SchmoJan/autonom-fahrendes-auto/IMG_20191203_085014.jpg

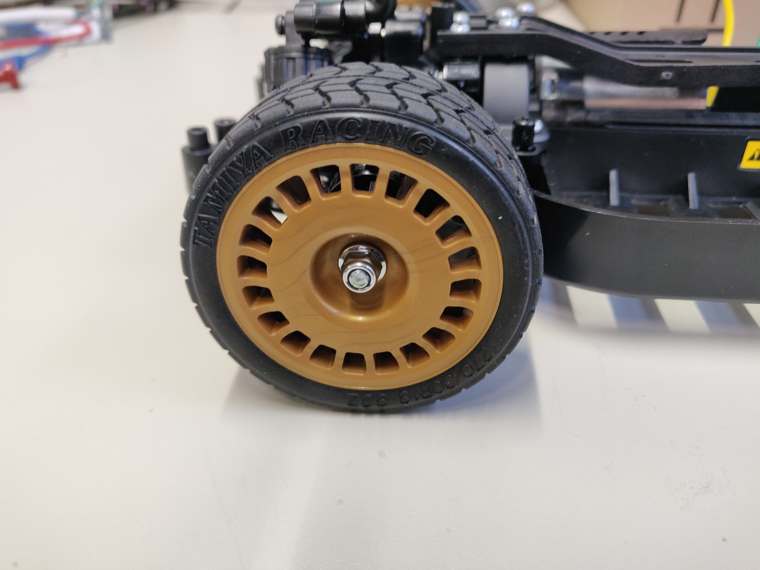
IMG_20191203_085014.jpg
