SchmoJan/autonom-fahrendes-auto/README.md

# autonom-fahrendes-auto

# Diplomarbeit der HTL WIEN 10
