SchmoJan/autonom-fahrendes-auto/IMG-20200114-WA0015.jpg

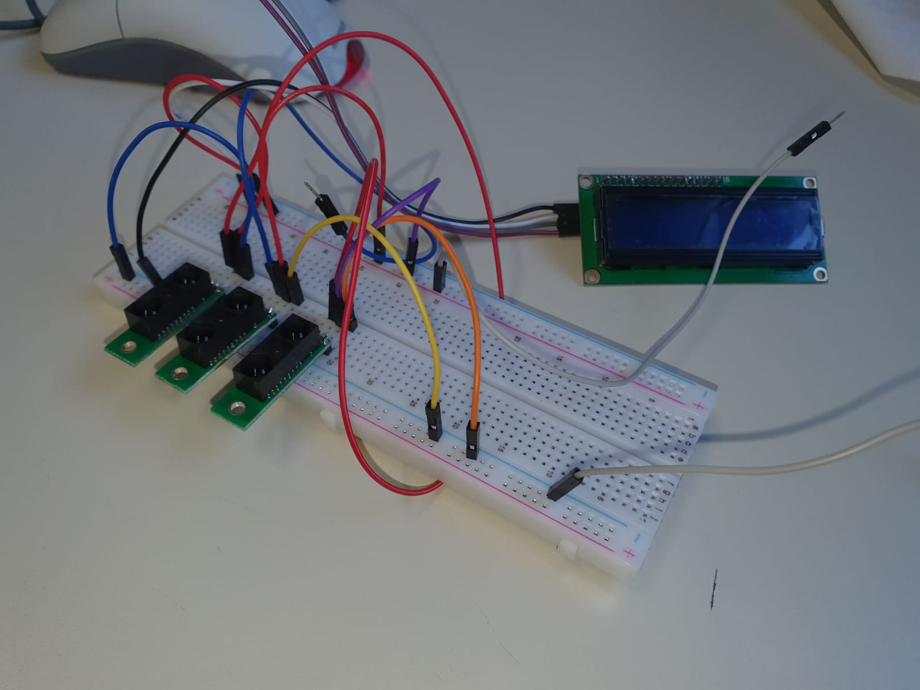
IMG-20200114-WA0015.jpg
