SchmoJan/autonom-fahrendes-auto/IMG-20200114-WA0016.jpg

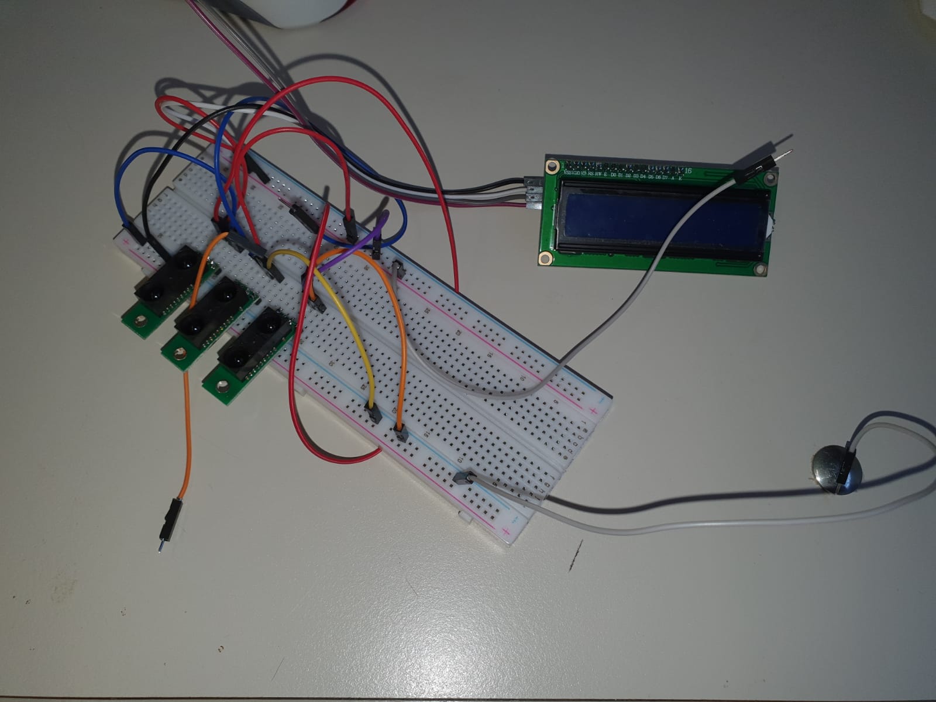
IMG-20200114-WA0016.jpg
