SchmoJan/autonom-fahrendes-auto/IMG-20200114-WA0017.jpg

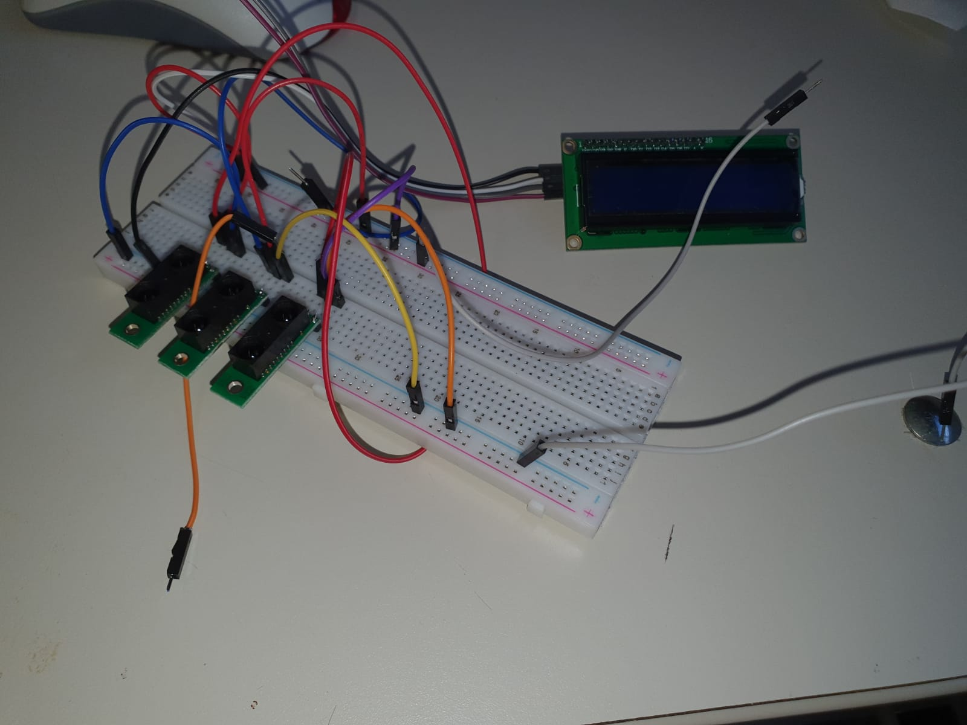
IMG-20200114-WA0017.jpg
