SchmoJan/autonom-fahrendes-auto/IMG_20191105_081237.jpg

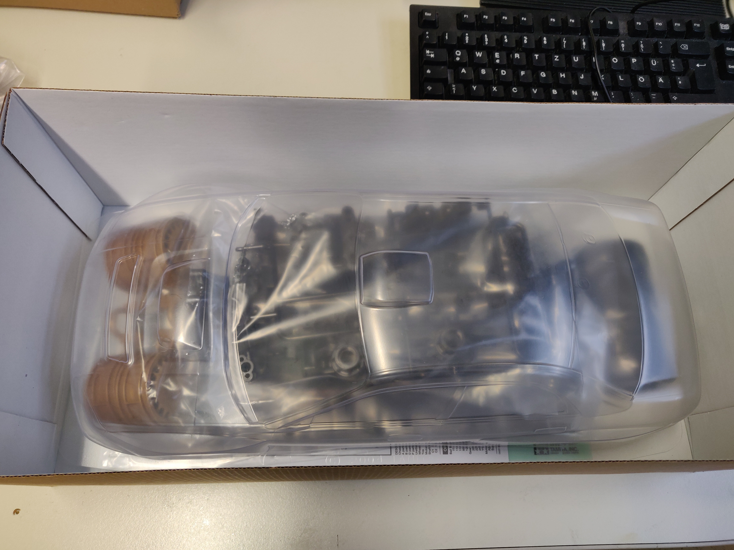
IMG_20191105_081237.jpg
