SchmoJan/autonom-fahrendes-auto/IMG_20191105_082230.jpg

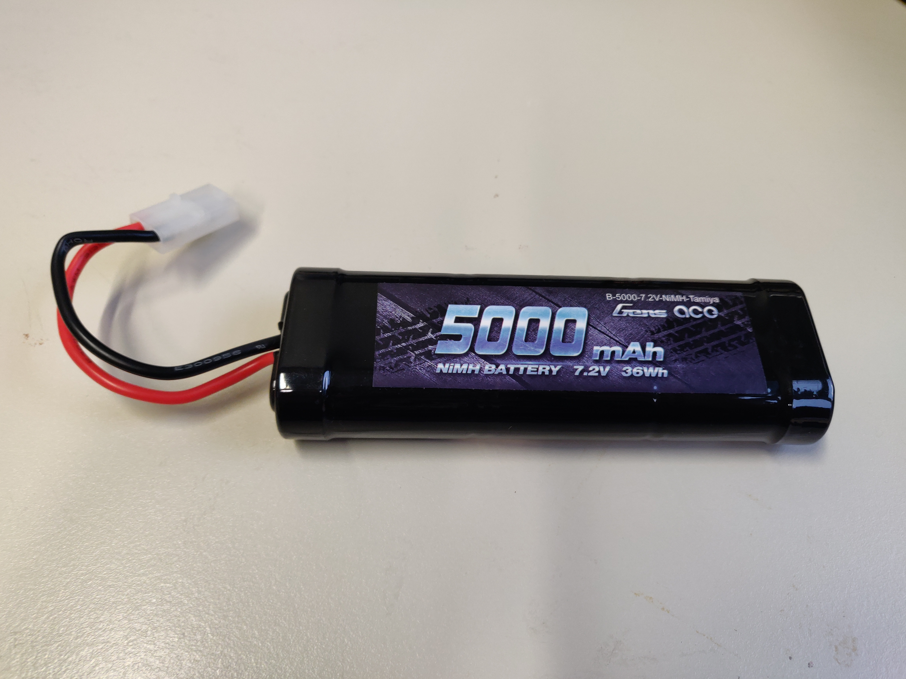
IMG_20191105_082230.jpg
