SchmoJan/autonom-fahrendes-auto/IMG_20191105_082252.jpg

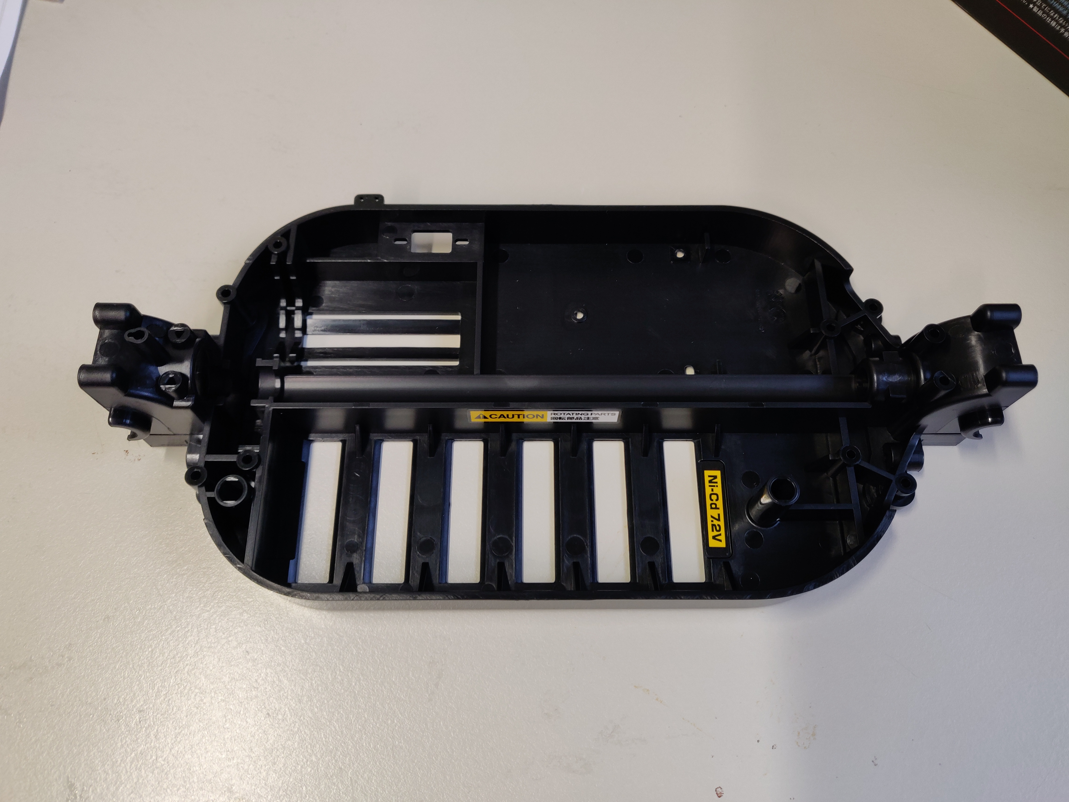
IMG_20191105_082252.jpg
