SchmoJan/autonom-fahrendes-auto/IMG_20191105_093449.jpg

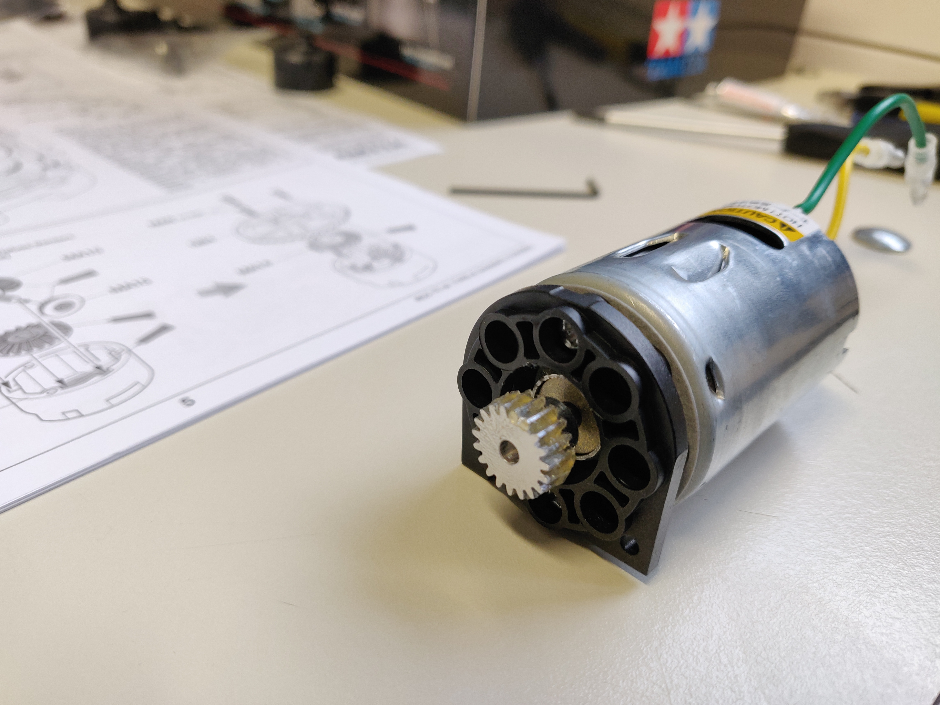
IMG_20191105_093449.jpg
