SchmoJan/autonom-fahrendes-auto/IMG_20191105_095227.jpg

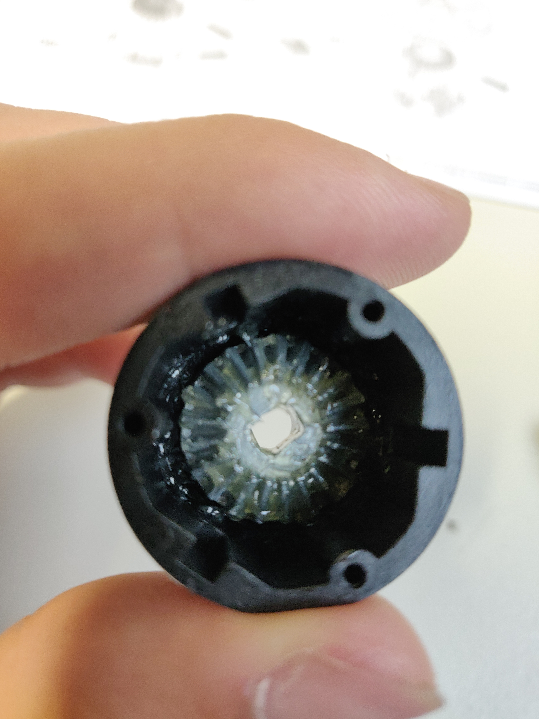
IMG_20191105_095227.jpg
