SchmoJan/autonom-fahrendes-auto/IMG_20191105_101122.jpg

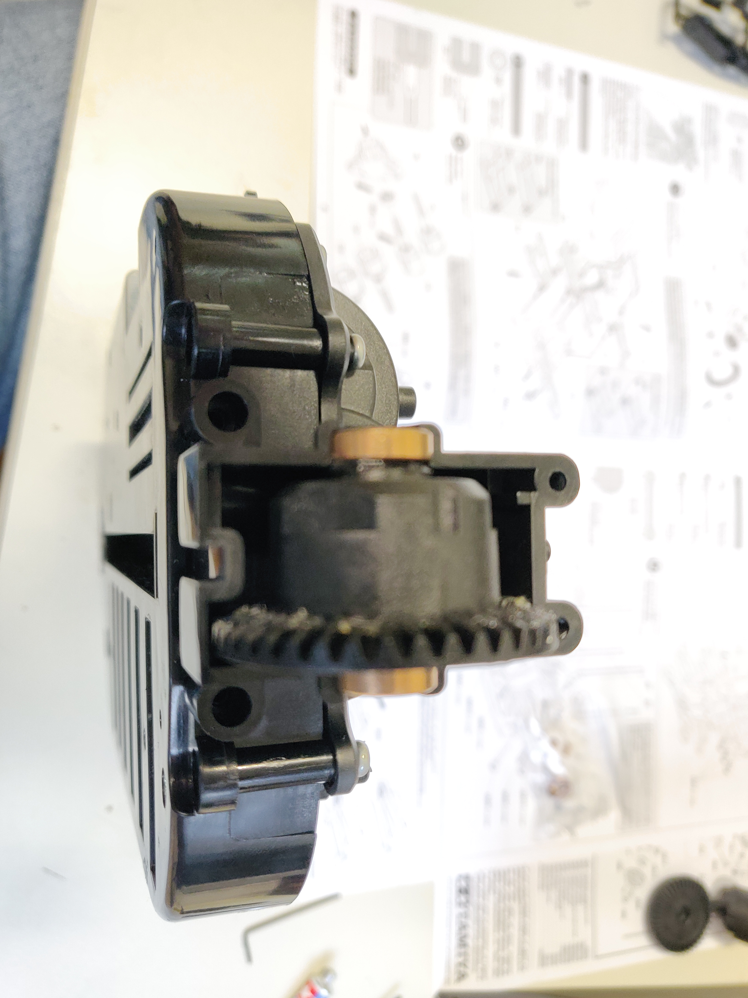
IMG_20191105_101122.jpg
