SchmoJan/autonom-fahrendes-auto/IMG_20191105_105233.jpg

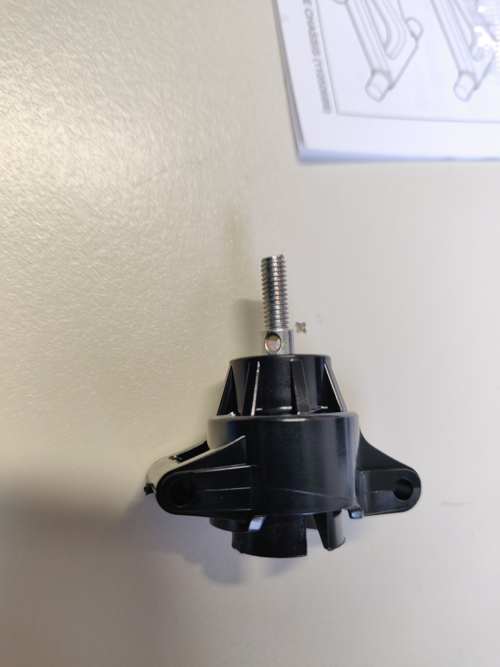
IMG_20191105_105233.jpg
