SchmoJan/autonom-fahrendes-auto/IMG_20191105_111206.jpg

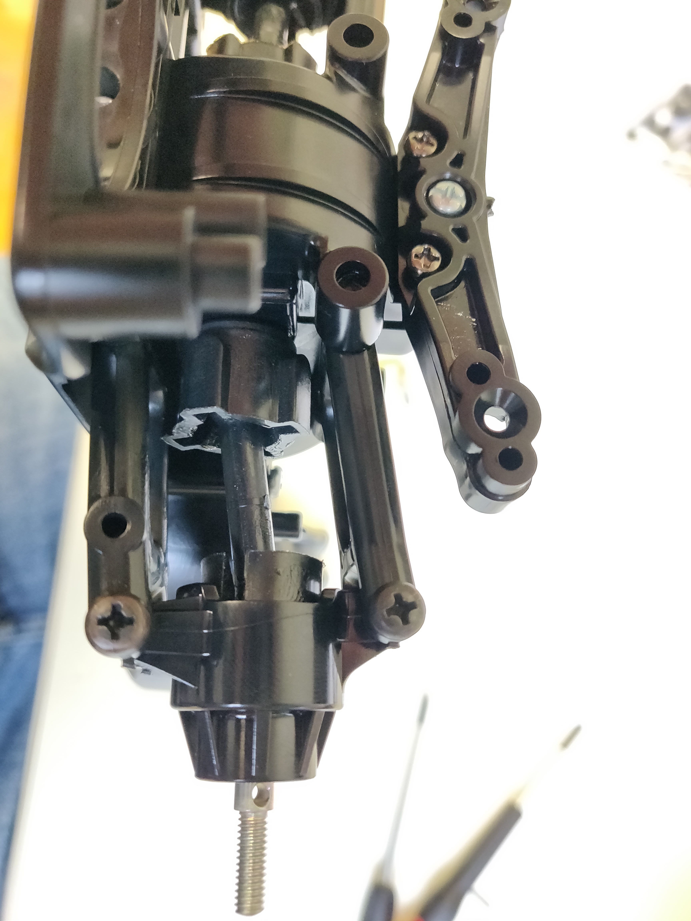
IMG_20191105_111206.jpg
