SchmoJan/autonom-fahrendes-auto/IMG_20191112_091550.jpg

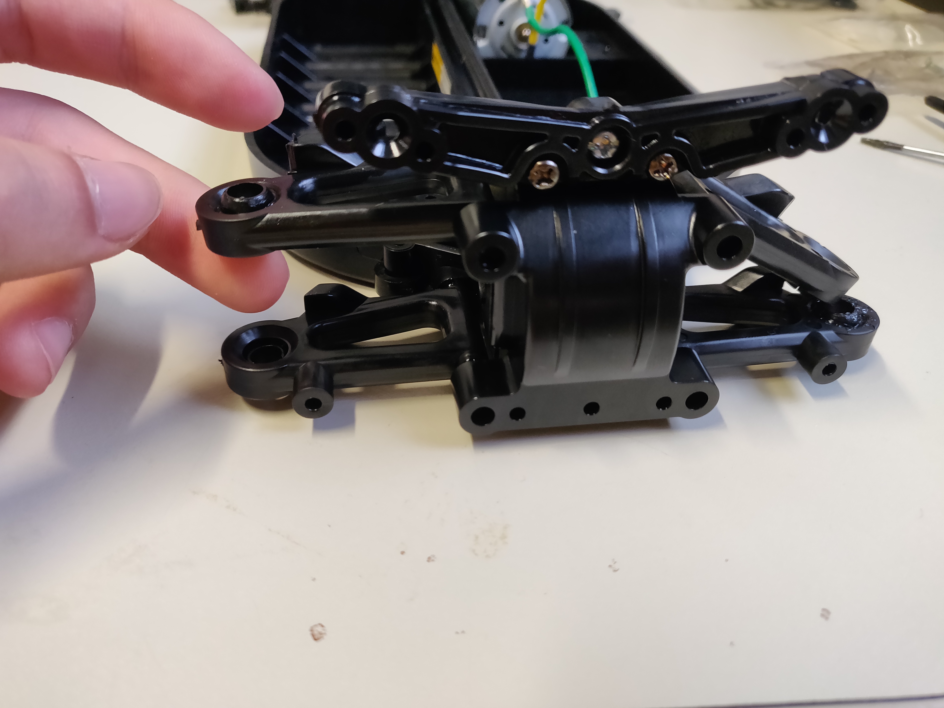
IMG_20191112_091550.jpg
