SchmoJan/autonom-fahrendes-auto/IMG_20191112_095958.jpg

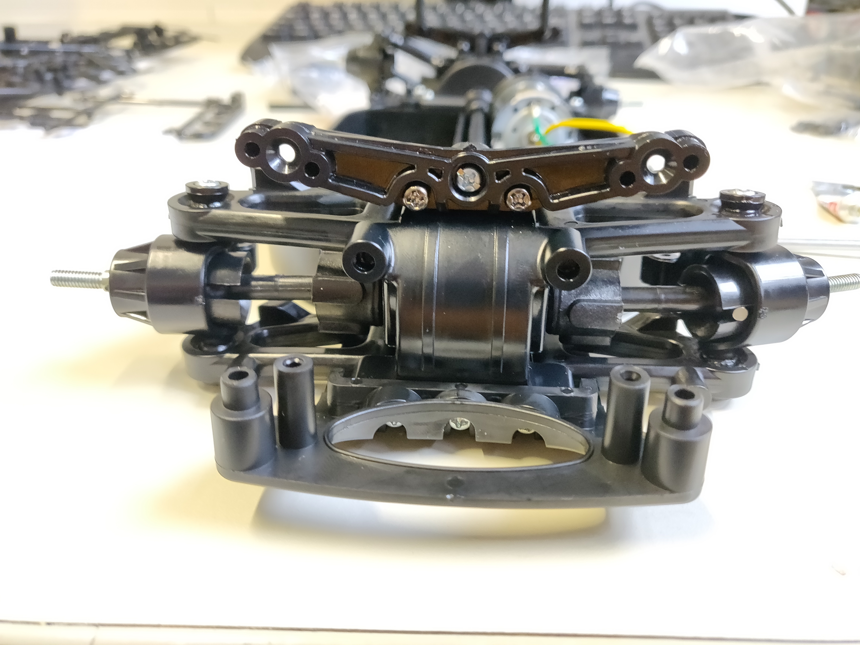
IMG_20191112_095958.jpg
