SchmoJan/autonom-fahrendes-auto/IMG_20191112_101134.jpg

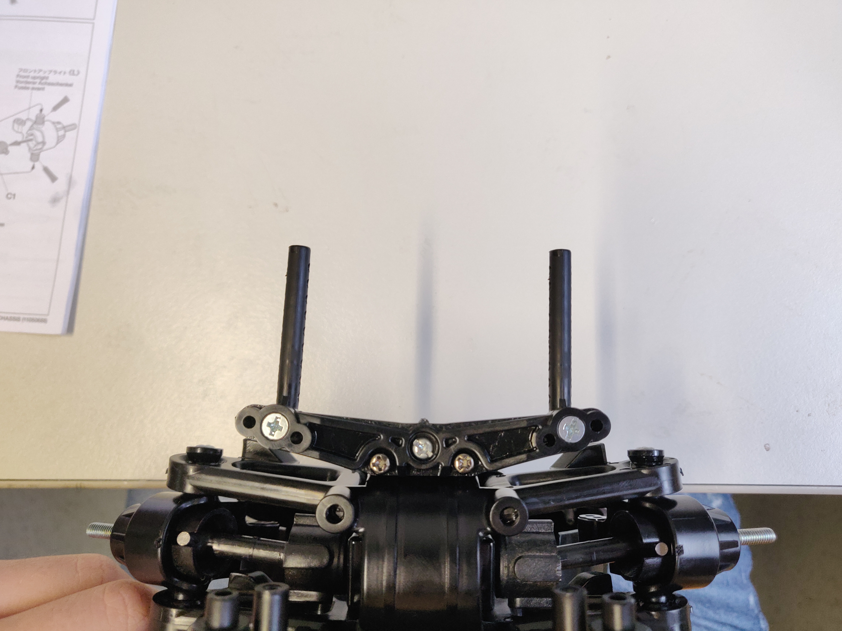
IMG_20191112_101134.jpg
