SchmoJan/autonom-fahrendes-auto/IMG_20191112_102006.jpg

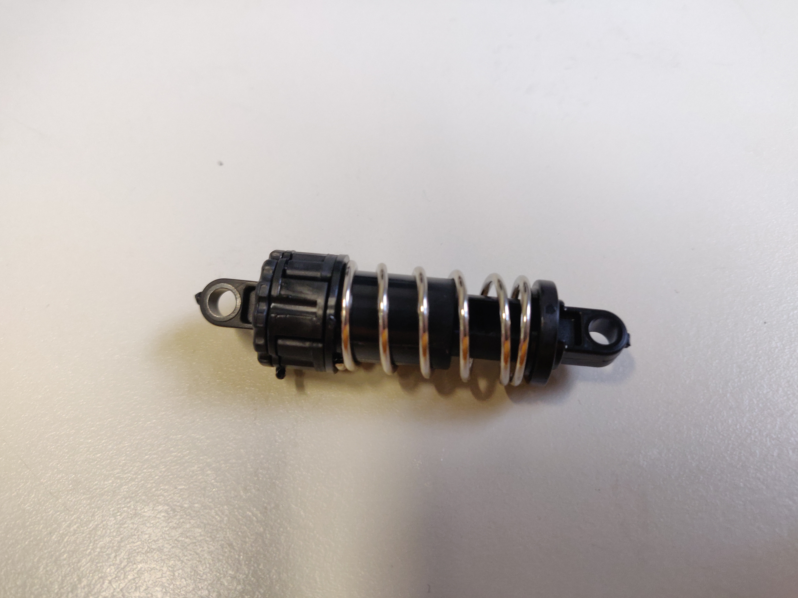
IMG_20191112_102006.jpg
