SchmoJan/autonom-fahrendes-auto/IMG_20191112_104751.jpg

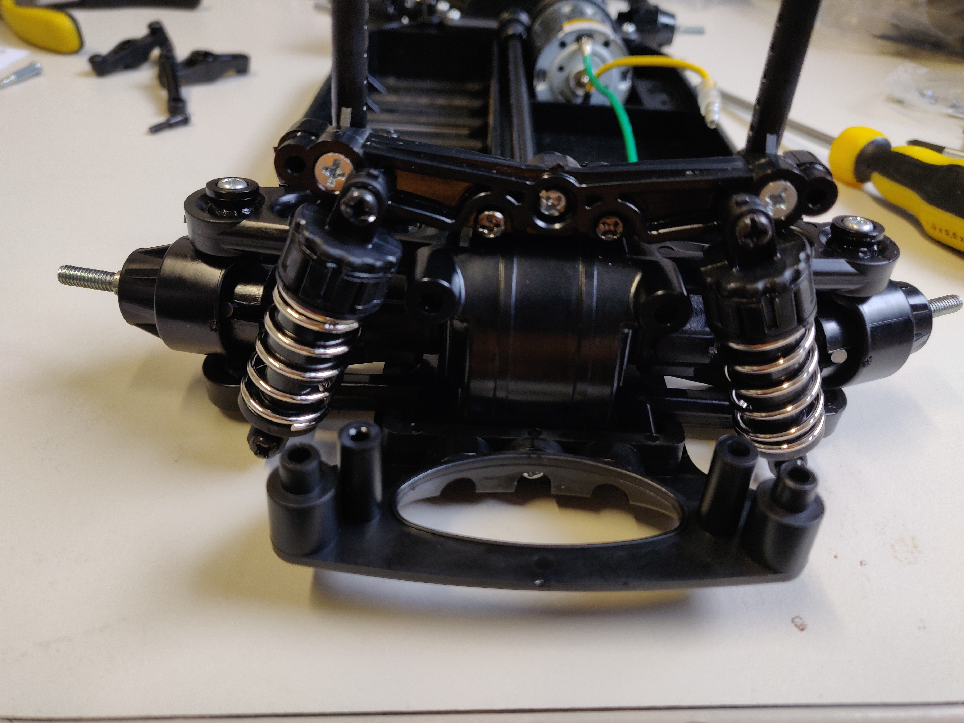
IMG_20191112_104751.jpg
