SchmoJan/autonom-fahrendes-auto/IMG_20191119_101627.jpg

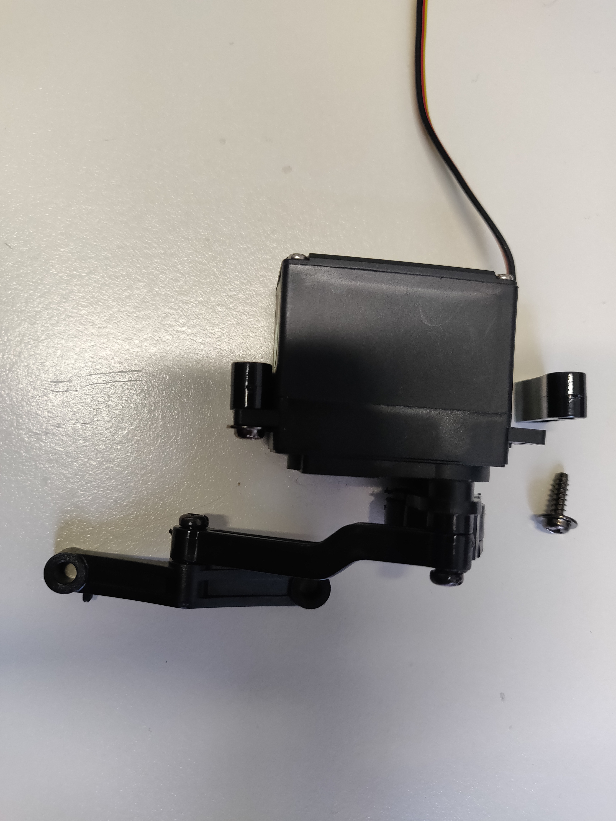
IMG_20191119_101627.jpg
