SchmoJan/autonom-fahrendes-auto/Motor_Ansteuerung_H-Brücke.png

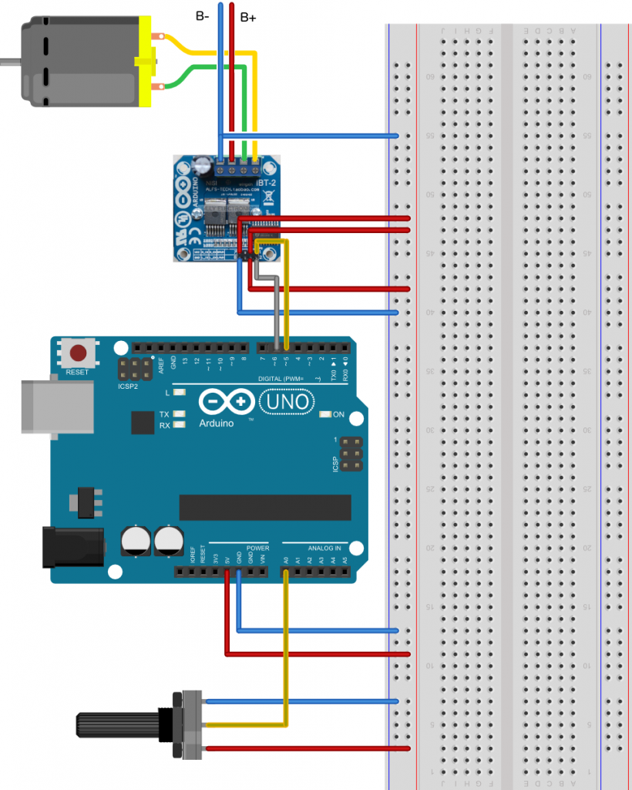
Motor_Ansteuerung_H-Brücke.png
