SchmoJan/autonom-fahrendes-auto/Selfmade_IR_Sensor.PNG

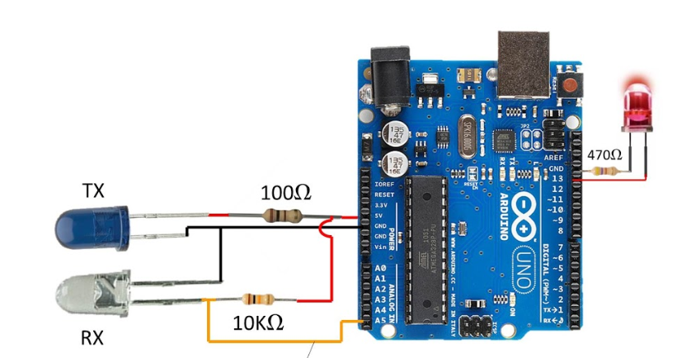
Selfmade_IR_Sensor.PNG
