SchmoJan/autonom-fahrendes-auto/(commit log)

2019-11-18 Add files via upload
    3 sensoren mit display ausgabe
2020-01-14 Add files via upload
    Schaltungsaufbau Sensoren+Display
2020-01-14 Add files via upload
    Circuit of "selfmade" IR-Sensor
