SchmoJan/autonom-fahrendes-auto/IMG_20191105_095504.jpg

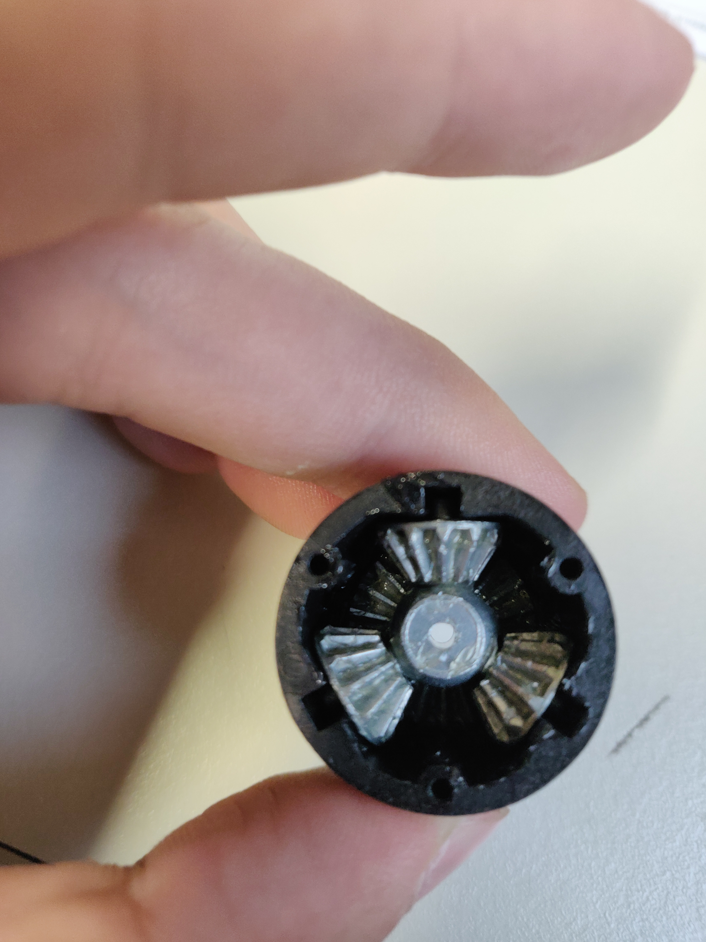
IMG_20191105_095504.jpg
