SchmoJan/autonom-fahrendes-auto/IMG_20191105_104448.jpg

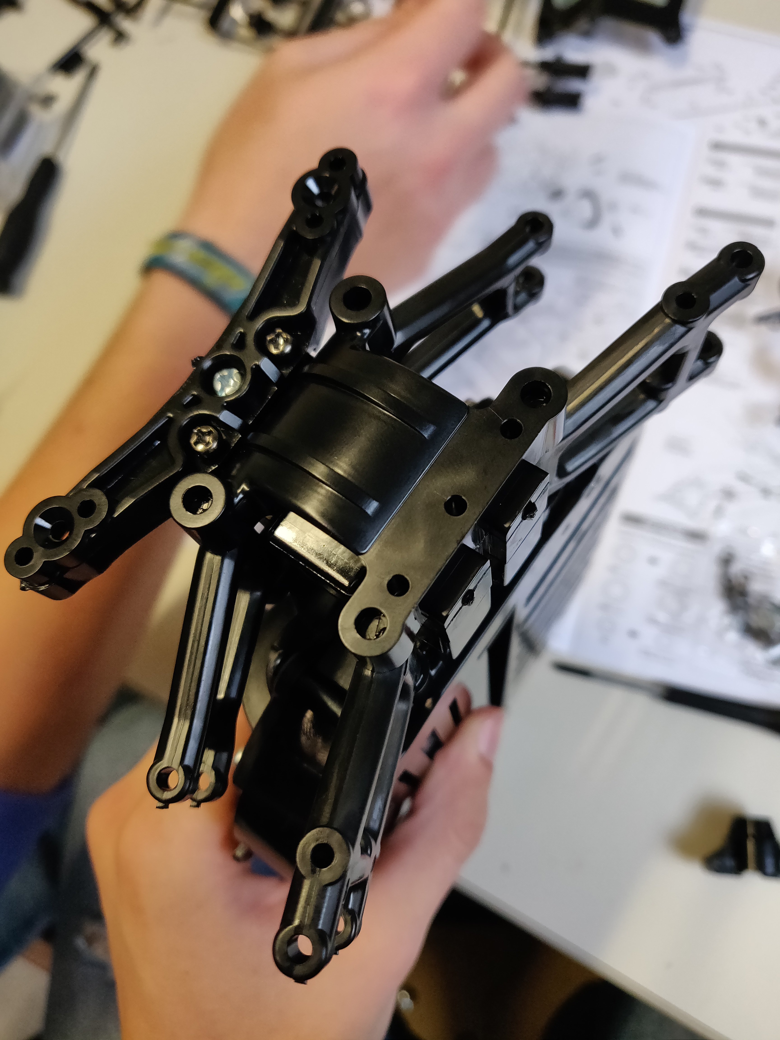
IMG_20191105_104448.jpg
