SchmoJan/autonom-fahrendes-auto/IMG_20191119_105100.jpg

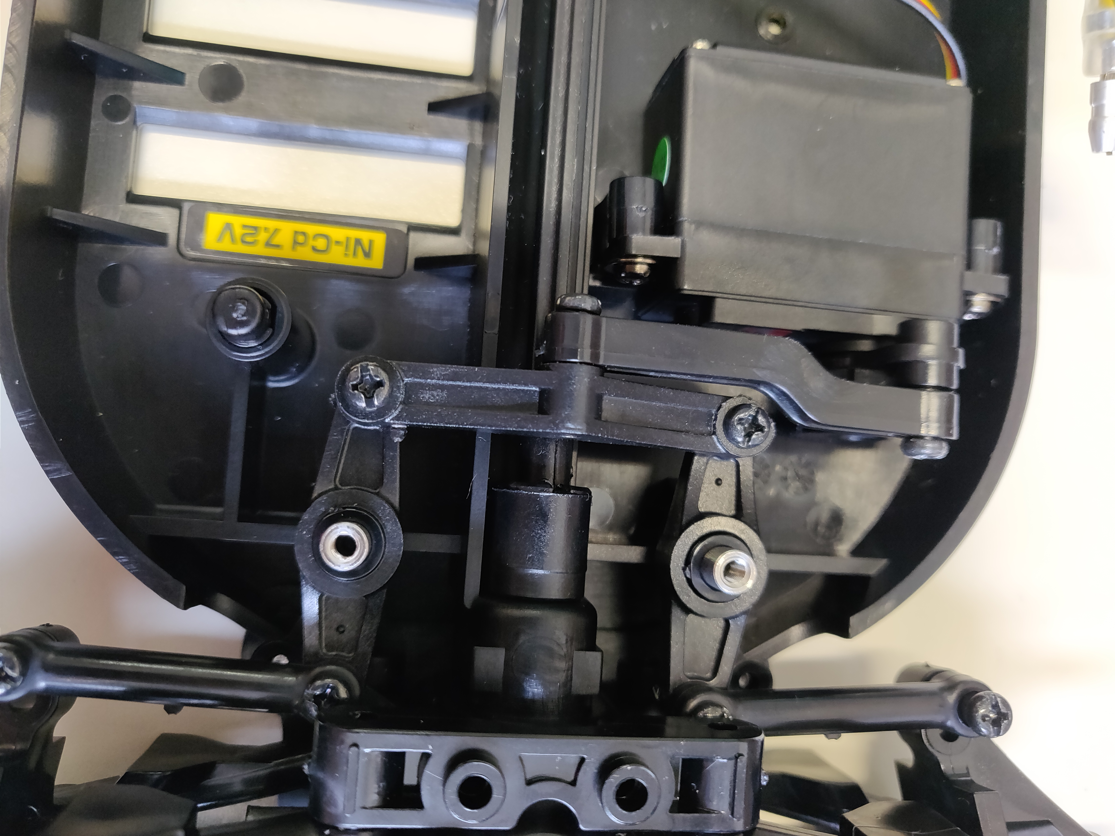
IMG_20191119_105100.jpg
