SchmoJan/autonom-fahrendes-auto/IMG_20191112_094929.jpg

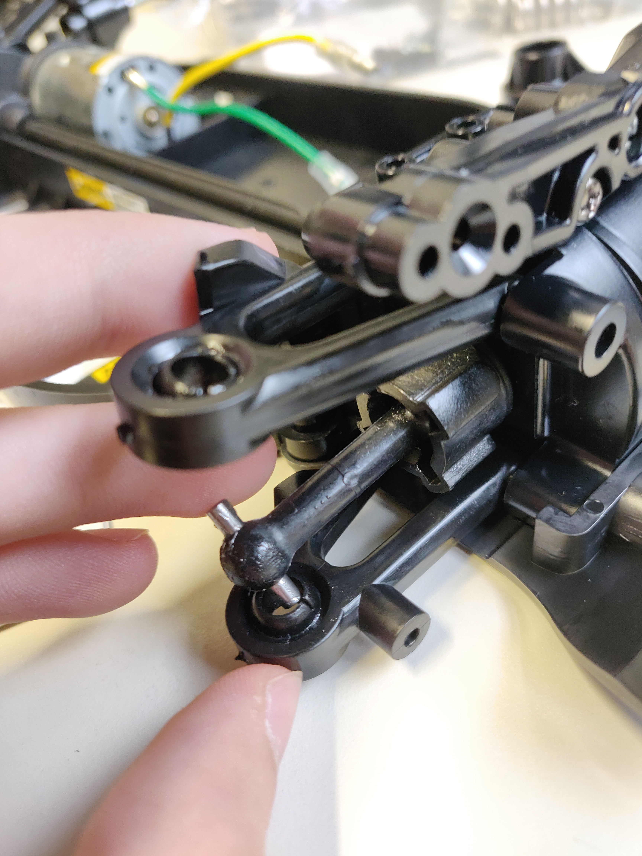
IMG_20191112_094929.jpg
